jaco-t/ocarina-E-/flute-ocarina.V1.pdf

# « FLUTE AUGMENTEE »

## Projet collectif MusicLab Artilect Début octobre 2017

## Debut de cahier des charges

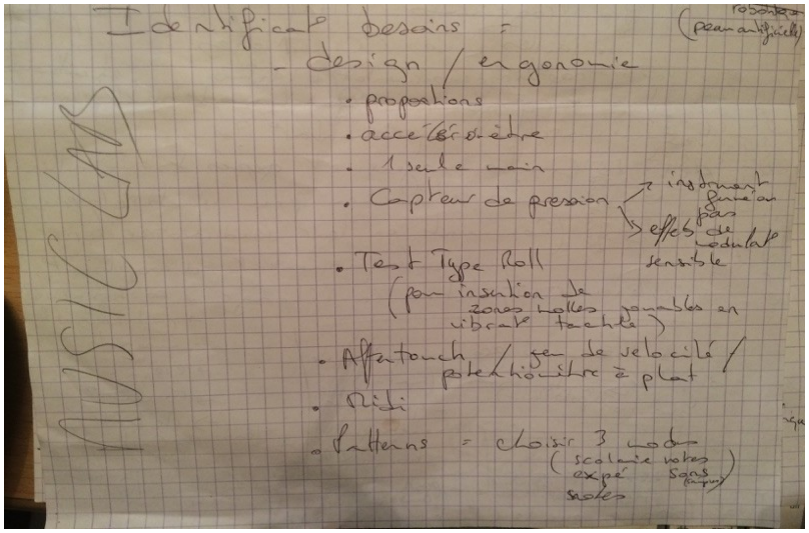
[picture p1: figure]

## Quoi, comment

- | FLUTE souffle capteur de souffle → | →
- AUGMENTEE
- - quels effets ? Diapo suivante
- - quels capteurs ? Diapo suivante
- Autonome / pour expander MIDI ? Les deux
- Matériel commercial existant ? Pourquoi ?
- Plaisir du DIY et prix

## Effets possibles/souhaitables

- Vibrato
- Tremolo
- Reverberation
- Pitch bend
- Sonorité
- Chorus
- Mouvement
- Pression
- Force
Effets | Capteurs

## Schéma électrique

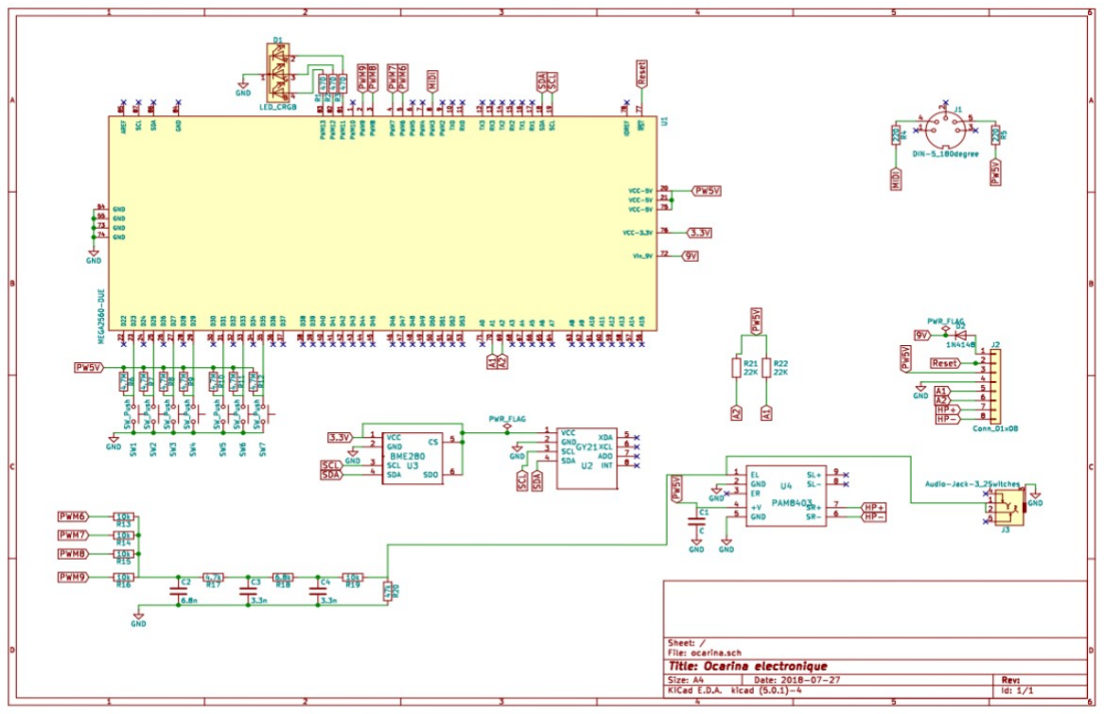
[picture p2: figure]

## Schéma électrique

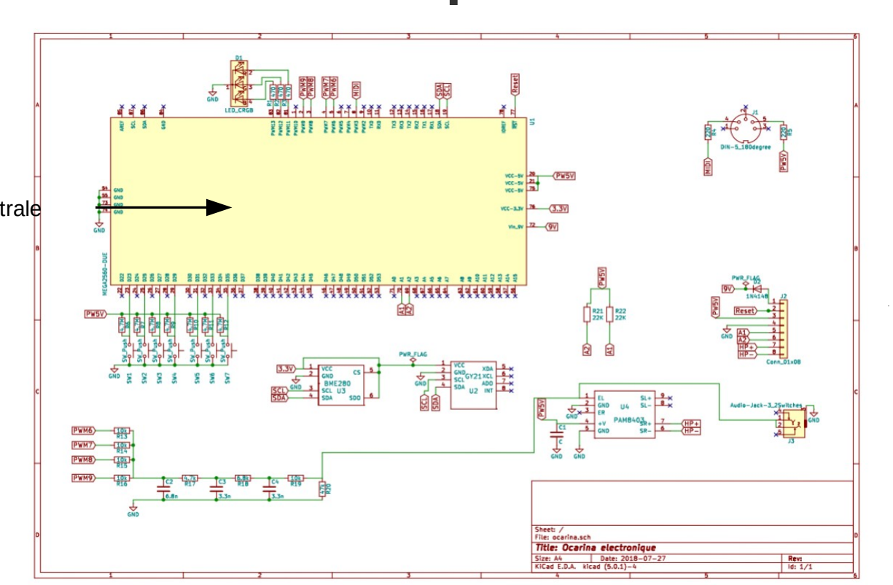
[picture p3: figure]

Unité centrale

## Schéma électrique

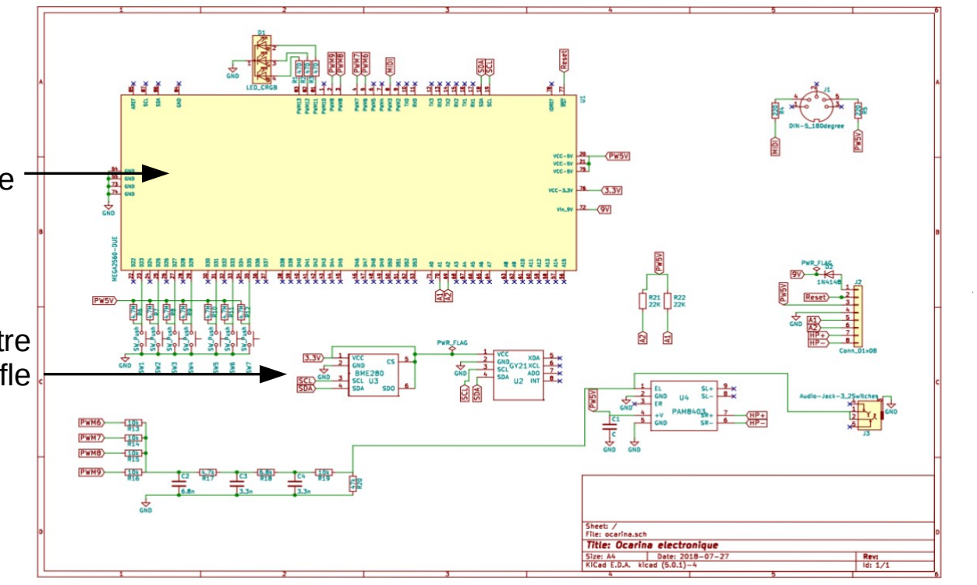
[picture p4: figure]

Unité centrale

Baromètre
capteur de souffle

## Schéma électrique

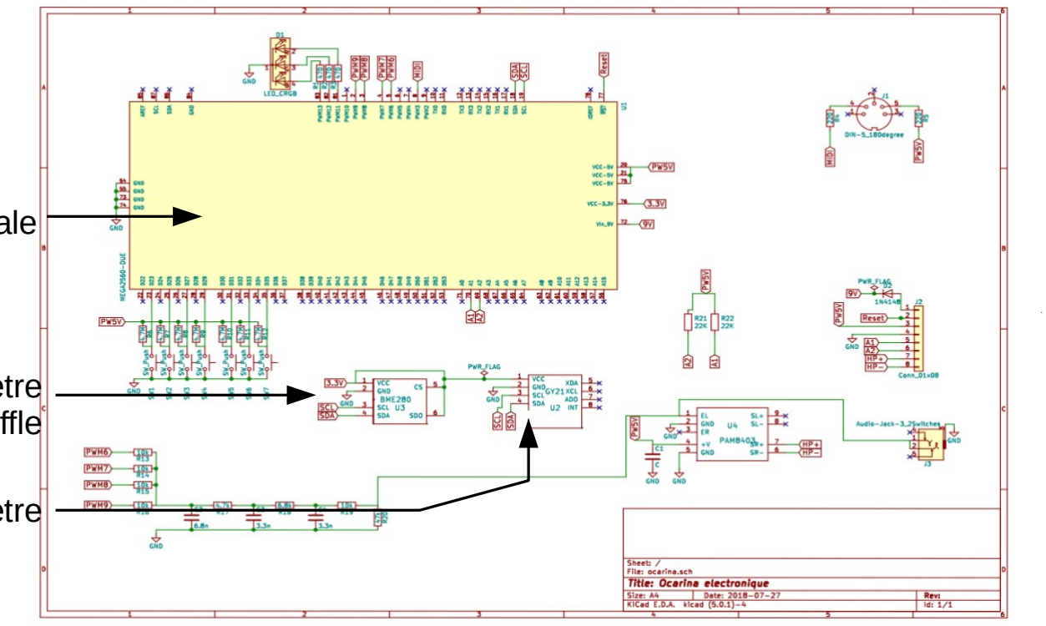
[picture p5: figure]

Unité centrale

Baromètre
capteur de souffle

Accéléromètre

## Schéma électrique

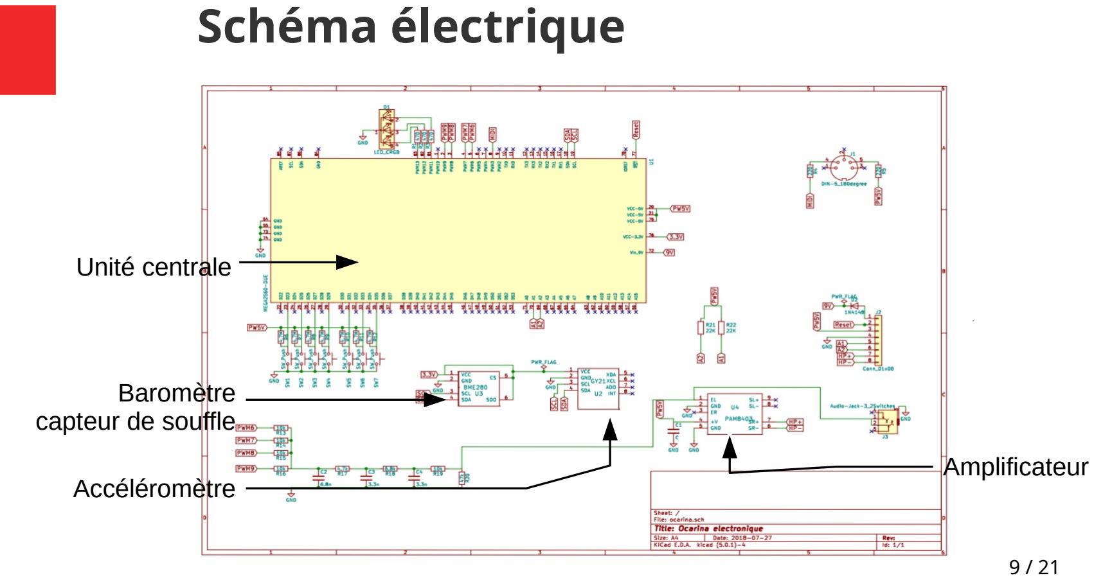
[picture p6: page 9]

Unité centrale

Baromètre
capteur de souffle

Accéléromètre

Amplificateur

## Logiciel

- Choix de la famille Arduino
- Capteurs disposant de librairies
- Développement de librairies spécifiques
- Génération du son sans composants externes

●

Inclinomètre/ accéléromètre
- Disponible en licence libre

## Prototypes

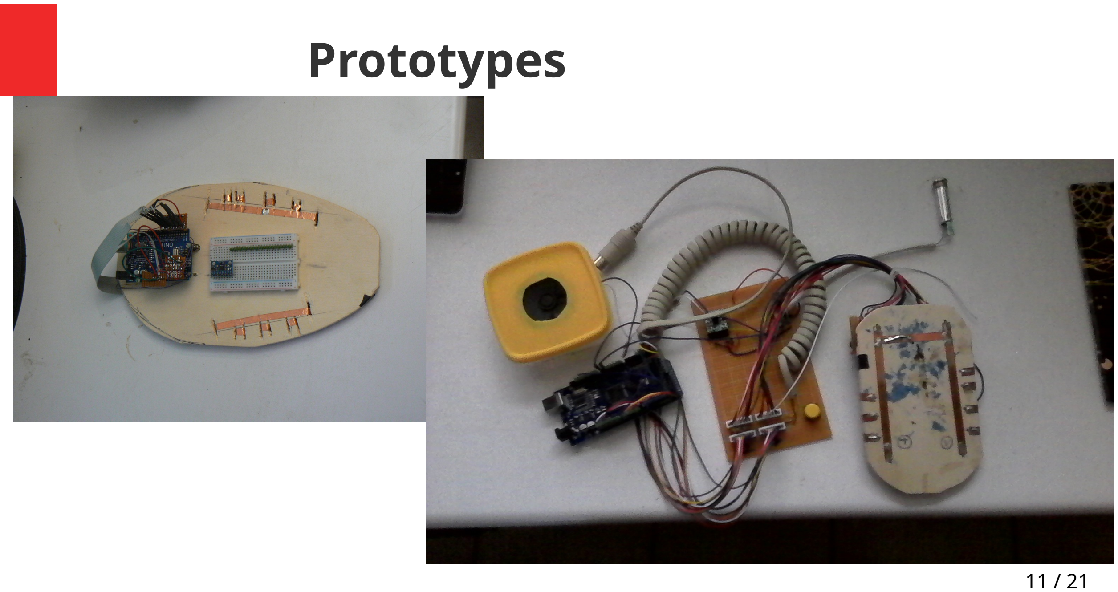
[picture p7: page 11]

## Circuit imprimé - conception

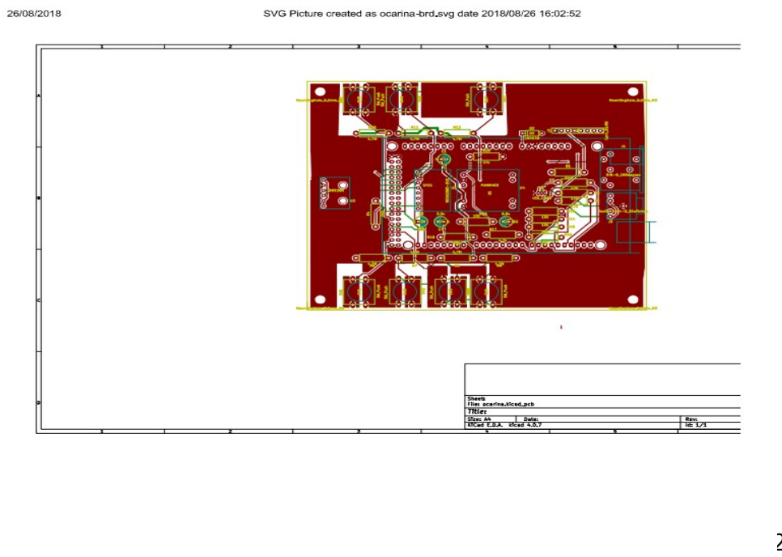
[picture p8: figure]

Utilisation de Kicad
Free

## Prototypes (suite)

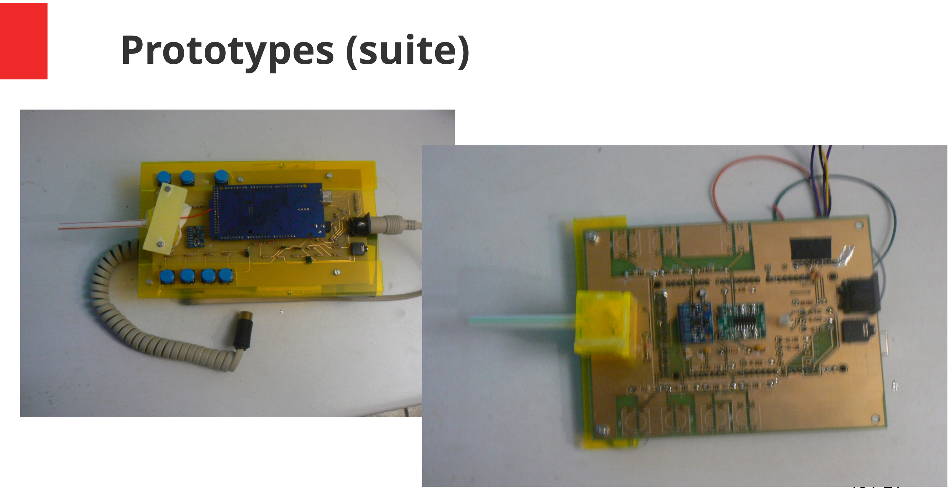
[picture p9: page 13]

## Capteur de souffle

- Pour des raisons économiques, choix d’un baromètre
- À régler, problème de l’humidité / condensation
- Développement d’un bec enfichable
- Visible sur le dernier prototype
- Voir diapo suivante

## Bec ocarina

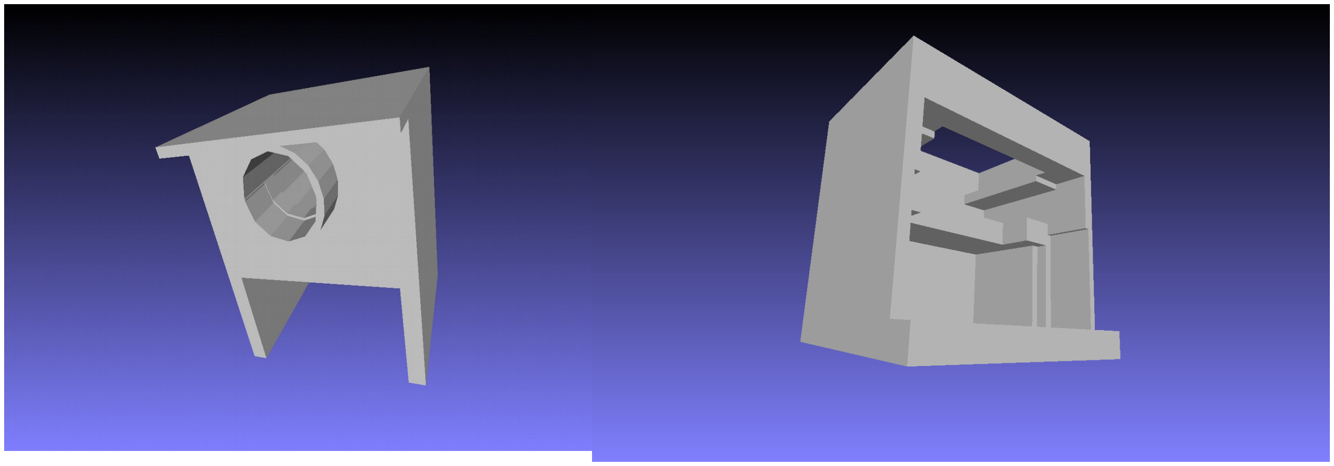
[picture p10: figure]

## Reste l’emballage :

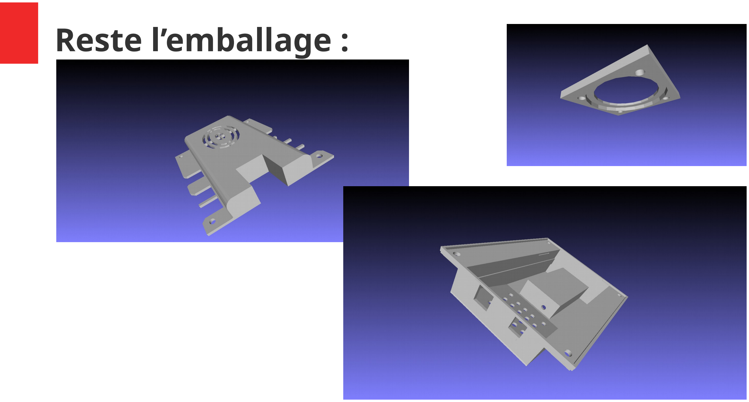
[picture p11: page 16]

## Bilan

●

Instrument libre de droits
- Fabrication par qui veut (bricoleur, maker...)
- Prix de revient < 80Euros

●
- Véritable instrument ? Démo !

## TABLATURE

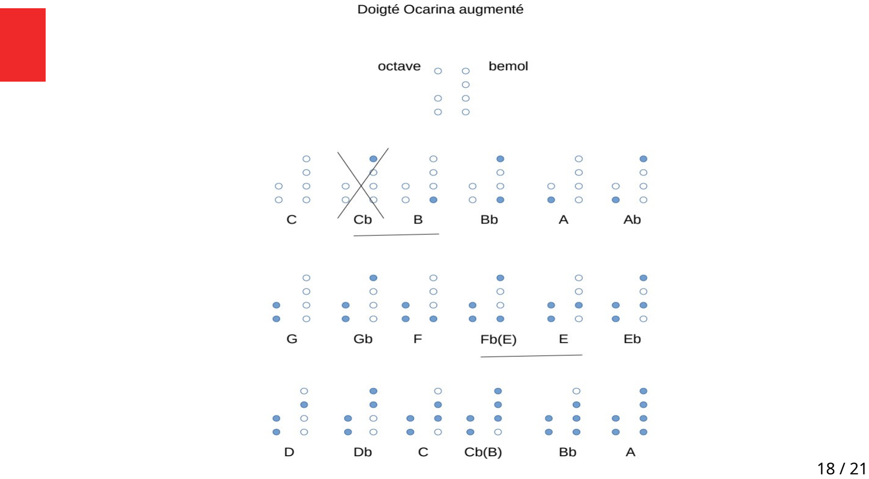
[picture p12: page 18]
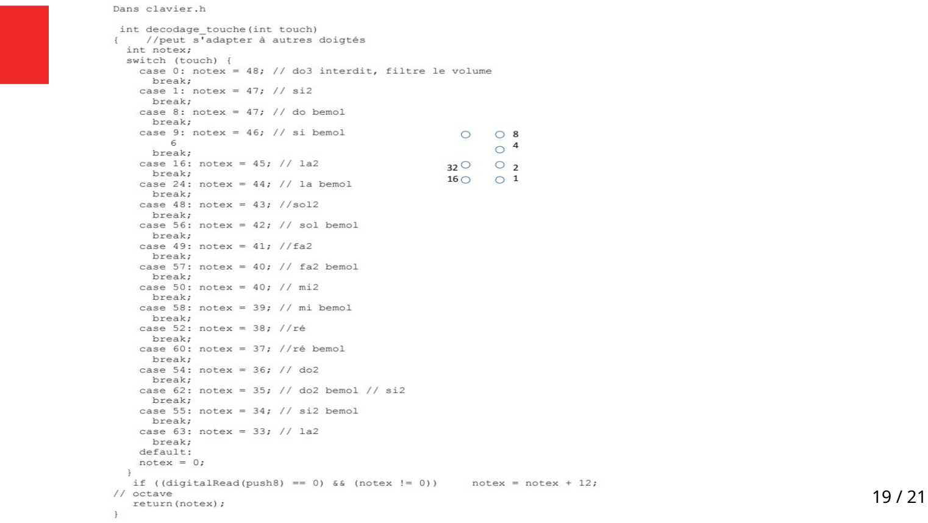
[picture p13: page 19]

## Parametrage MIDI

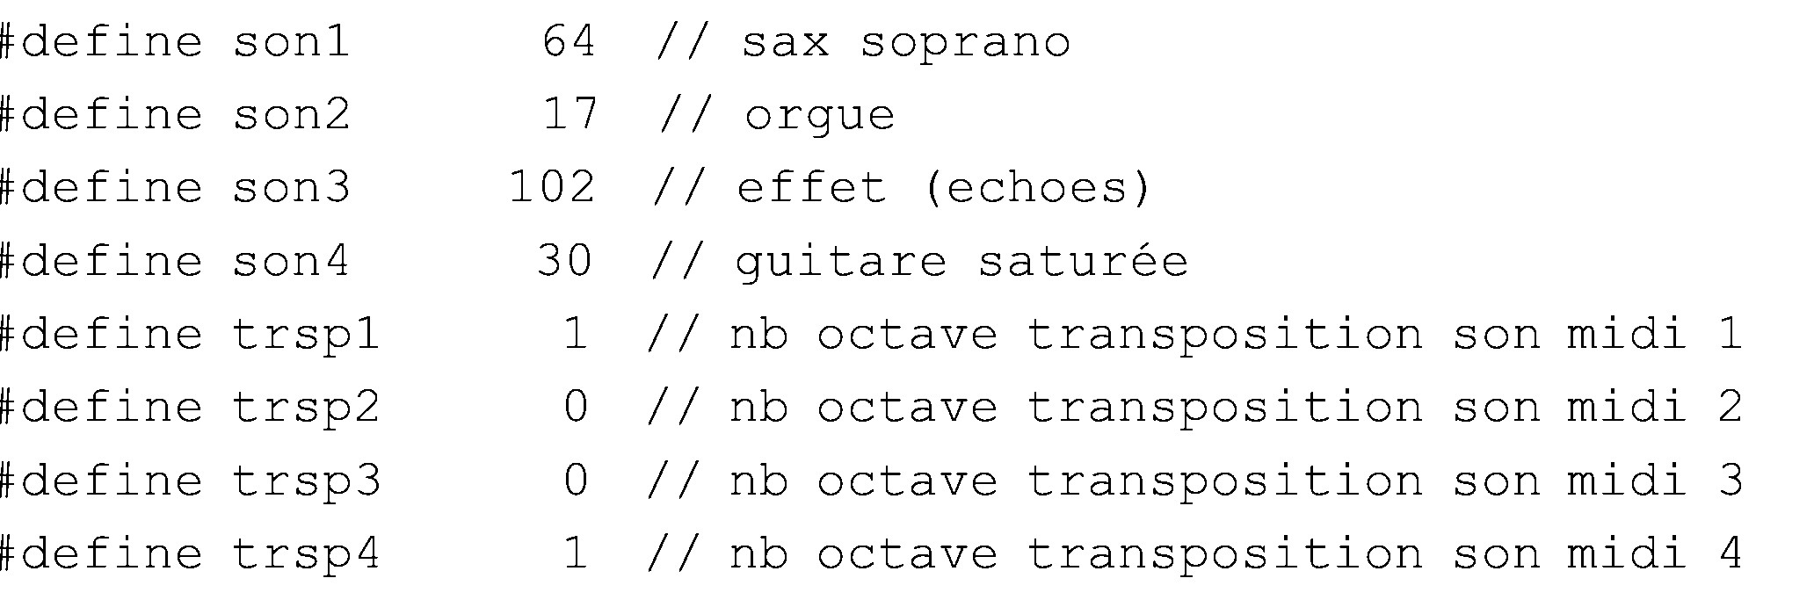
[picture p14: figure]

## Version 1

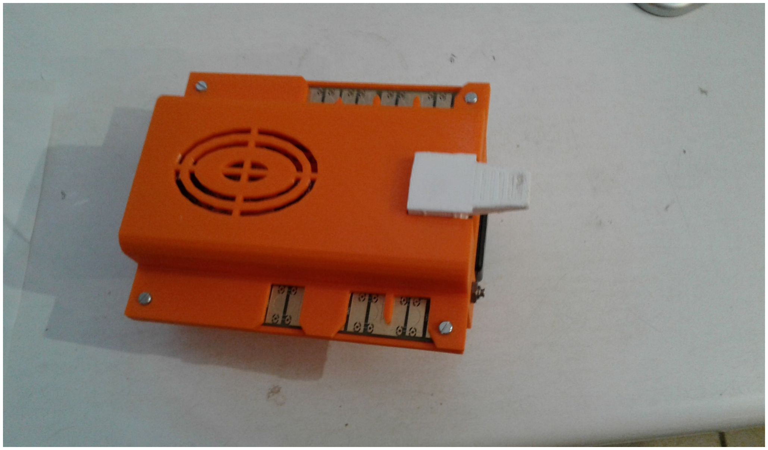
[picture p15: figure]
