jaco-t/ocarina-E-/Tablature-ocarina-musiclab.pdf

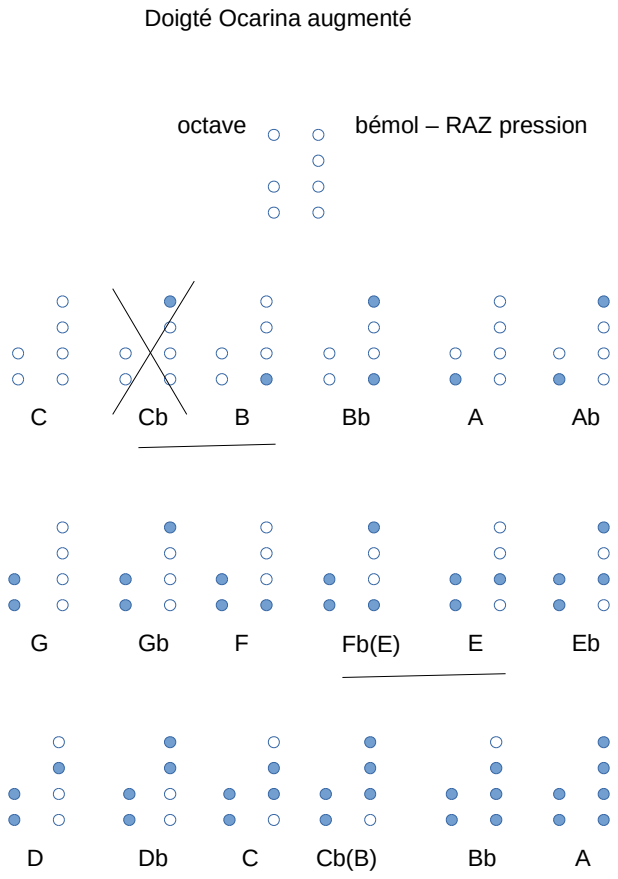
[picture p18: page 1]
octave; bémol – RAZ pression

Doigté Ocarina augmenté
