jaco-t/ocarina-E-/ocarina E+/ocarinaV2/sax256_byte.h

const byte sax256byte[256] =
{128 , 125 , 120 , 115 , 109 , 102 , 97 , 90 , 83 , 77 , 71 ,  62 , 57 , 50 , 44 , 45 , 46 , 49 , 50 , 46 , 41 , 35 , 31 , 27 ,  24 , 26 , 32 , 39 , 48 , 54 , 60 , 68 , 75 , 72 , 62 , 54 , 48 ,  46 , 48 , 54 , 56 , 53 , 50 , 46 , 40 , 32 , 28 , 31 , 29 , 26 ,  27 , 30 , 38 , 36 , 30 , 20 , 12 , 6 , 2 , 3 , 12 , 28 , 40 , 51   , 63 , 74 , 84 , 93 , 100 , 98 , 92 , 90 , 88 , 84 , 78 , 72 , 82 , 96 , 108 , 118 , 128 , 132 , 136 , 141 , 144 , 148 , 150 , 151 , 148 , 146 , 144 , 142 , 138 , 134 , 130 , 128 , 128 , 138 , 150 , 162 , 180 , 200 , 202 , 204 , 206 , 208 , 210 , 212 , 214 , 216 , 218 , 210 , 208 , 216 , 218 , 220 , 222 , 224 , 225 , 227 , 229 , 231 , 234 , 237 , 240 , 243 , 246 , 248 , 250 , 242 , 230 , 208 , 200 , 198 , 190 , 185 , 187 , 185 , 183 , 183 , 179 , 173 , 170 , 168 , 162 , 157 , 150 , 144 , 142 , 144 , 150 , 156 , 168 , 164 , 166 , 168 , 169 , 170 , 171 , 172 , 171 , 168 , 160 , 150 , 140 , 132 , 126 , 124 , 120 , 116 , 108 , 106 , 102 , 98 , 92 , 89 , 88 , 82 , 75 , 70 , 65 , 58 , 48 ,  42 ,  36 , 34 , 32 , 30 , 29 , 28 , 29 , 30 , 31 , 33 , 35 , 37 , 39 , 42 , 45 , 46 , 45 , 43 , 40 , 46 , 55 , 64 , 73 , 78 , 82 , 85 , 88 , 92 , 95 , 94 , 91 , 88 , 85 , 84 , 80 , 78 , 80 , 82 , 85 , 88 , 92 , 95 , 94 , 88 , 84 , 88 , 90 , 92 , 94 , 92 , 89 , 85 , 86 , 88 , 90 , 99 , 110 , 124 , 134 , 140 , 144 , 148 , 150 , 154 , 156 , 154 , 148 , 146 , 140 , 136 , 132 , 128};
