jaco-t/ocarina-E-/ocarina E+/ocarinaV2/sinus256_byte2.h

const byte sin256byte[]=
{
0,2,5,7,9,10,12,14,16,18,
20,22,24,26,28,30,32,34,36,38,
40,42,44,46,48,49,51,53,55,57,
60,62,62,65,67,69,71,73,75,77,
79,81,83,85,87,89,91,93,94,96,
98,100,102,104,106,108,110,112,114,116,
118,120,122,124,126,128,130,132,134,136,
138,140,142,144,146,148,150,150,152,154,
156,159,161,163,165,166,168,170,172,174,
176,178,180,182,184,186,188,190,192,194,
196,198,200,202,204,206,208,210,212,214,
216,218,220,222,224,226,227,229,231,233,
235,237,239,241,243,245,247,249,248,247,
246,244,242,240,238,236,234,232,230,228,
226,224,222,220,218,216,214,212,210,207,
206,204,203,201,199,197,195,193,191,189,
187,185,183,181,179,177,175,173,171,169,
167,165,163,161,160,158,156,154,152,150,
147,145,143,142,140,138,136,134,132,130,
129,127,125,123,121,119,117,115,112,110,
108,106,104,103,101,99,97,95,93,91,
90,88,86,84,82,80,78,76,74,72,
70,68,66,64,62,60,58,56,54,52,
50,48,46,44,42,40,38,36,34,32,
31,29,17,25,23,21,19,17,15,13,
11,9,7,5,3,1
};
 
