jaco-t/ocarina-E-/ocarina E+/ocarinaV2/table_musique.h

//table des increments pour faire notes de do2 � do4, avec fe=16kHz
//increments fois 256, pour r�aliser une op�ration pr�cise
//cette valeur sera manipul�e pour faire du vibrato, ou du pitch bend

const int increment[40] =  {115 , 122 , 129 , 137 , 145 , 154 , 163 , 173 , 183 , 194 , 206 , 218 , 231 , 244 , 259 , 274 , 291 , 308 , 326 , 346 , 366 , 388 , 411 , 435 , 461 , 489 , 518 , 549 ,582 , 616 , 652 , 692 , 732 , 776 , 822, 870, 922 , 978 , 1036 , 1098 } ;
